Sierrastdio/Dual328P/(list of files, drawings)

Other design files:
DST.sim1
