Sierrastdio/Dual328P/(commit log)

2026-01-21 구체적인 펌웨어 재설계, 시스템 수정 반영.
2026-01-21 나노가 하나 더 추가되면서 핀배치 다시 검사해야할듯.
2026-01-21 SMU_light 버전 업로드.
2026-01-22 SMU_light 버전 수정 업로드.
2026-01-22 README 수정.
2026-01-22 IC칩 불량여부 체크중.
2026-01-22 프롬프트 파일 이동 및 README 수정.
2026-01-23 74HC04를 제외한 대략적인 회로도 첫번째 버전.
2026-01-26 74HC165 두개를 추가함으로써 Nano#2 설계 구체와, prompt.md는 아직 정보 업데이트가 안되어있고 정보충돌도 많아 잠시 사용 X.
2026-01-27 prompt.md 1차 업데이트 시도.
2026-01-29 core1firm.ino, core2firm.ino 폴더명 다른거 수정, core2firm도 코어1의 것과 같은것으로 일단 간주.
2026-01-30 코어 관련 폴더명, 파일명 수정.
2026-01-30 DDU 코드 74HC165 두개 적용된 설계 적용. 128x64 GLCD로 출력장치 변경.
2026-01-30 DDU코드 시리얼프린트 부분 전부 삭제 및 코드 수정.
2026-01-31 파이썬 인터페이스 작성. 따라서 전용 SMU_light_2.ino 생성및 작성.(+ 페이징 기능 추가)
2026-01-31 SMU_light_2 메모리 부족등 문제 해결, main.py 코드 시리얼연결 성공. SMU_light_2 넣은 아두이노에 :w 0 0 등 시도. 성공으로 추정.(RX, TX 불 들어옴)
2026-02-01 아직 작동테스트를 안한 명령어 통합 버전인 mer. light2-main 버전과 공존 시킴. 이외의 smu 예전 버전은 삭제함.
2026-02-01 추가명령어 구현시도로 인한 SMU_mer.ino 코드 수정. 이에 맞춰 대대적인 SMU업데이트와 VMF, main_mer.py 업데이트 예정.
    [SMU_mer.ino]
2026-02-01 메뉴얼부터 개판나고 핀 배치도 오류가 많은거 같아서 코드 개발은 일단 뒤로 미루고 회로도랑 핀 배치표 먼저 제대로 만들 예정.
2026-02-01 메뉴얼 수정중.
2026-02-01 코어2 주소 버퍼까지 수정함.
2026-02-02 28C256 까지 수정함.
2026-02-02 easy eda에서 회로도 28c245, 74hc04, 74hc138 배선을 주로 수정했음, 나노#1과 나노#2 회로 수정할 예정. 기념으로 A4 4장크기 회로도 프린트함.
2026-02-03 코어 배선표 수정 및 74HC04 배선표 까지 수정함.
2026-02-03 595 까지 배선표 수정함.
2026-02-03 PinManual.md 한바퀴 수정완료.
2026-02-03 코어1, 2, 28C256, 74HC245 추가 수정.
2026-02-03 28C256, 코어1, 2 추가수정.
2026-02-03 28C256 추가수정.
2026-02-03 세부 오류들 수정.
2026-02-03 74HC138 삭제, PC4로 A14 직접 제어.
2026-02-03 오류 수정.
2026-02-04 바뀐 핀맵에 맞춰 core1VMF2.ino와 SMU_mer2.ino 작성.
2026-02-04 코어용 74HC595를 두개 추가함으로서 코어당 128바이트 페이지 128개 = 총 16KB 접근 가능해짐.
2026-02-04 변경된 설계 적용 -> SMU_mer.ino, core1VMF.ino
2026-02-04 PinManual.md가 prompt.md보다 더 프롬프트 같아서 그냥 prompt.md 삭제.
2026-02-05 2월 5일 버전 회로도 업로드.
2026-02-05 근데 이거 페이지 별로 일일이 업로드 다 해야 하냐
2026-02-06 74HC595 추가한 core2 코드도 작성함.
2026-02-09 시뮬레이션 용 회로
    [DST.sim1]
2026-02-10 시뮬레이션 용 회로 만드는중.
    [DST.sim1]
2026-02-10 출력용 나노와 74HC165-1,2 의 연결만을 남겨놓음.
    [DST.sim1]
2026-02-10 명령어셋 표시
    [DST.sim1]
2026-02-11 시뮬레이션 결과, 버스 회로도 연결 이렇게 하는거 아닌거 같음, 리셋핀 제어 동작 안함, 데이터 버스로 뭔가 출력은 됐으나 주소선(74HC595-1) 부분이 반응이 없는거 같음.
    [DST.sim1]
2026-02-12 리셋핀 문제는 그냥 툴 오류였고 이제 버스 연결 안되는거 해결해야함.
    [DST.sim1]
2026-02-12 리포지토리 살짝 정리.
2026-02-14 변수명 'SP' AVR 라이브러리 충돌로 인한 컴파일 에러 해결, 포트제어 16진수에서 2진수로 바꿔 가독성 높임.
2026-02-14 TESdevac의 클로드 말로는 나노#1에 28C256의 A14가 연결되어 있지 않아 뱅크를 선택해서 데이터를 쓸수 없다고 해서 나노#1의 A5핀 사용을 PinManual.md 에 추가하고 SMU코드도 다시 짬.
2026-02-15 remove 'main.py' and rename the 'main_mer.py' to 'main.py'
    main_mer.py는 SMU와 Core가 따로 개발되었을당시 약간에 차이가 있던 명령어셋을 통합하고자 생긴 파일입니다.
    _mer가 붙은 파일들을 기반으로 개발이 진행되면서 구버전인 main.py의 이름을 main_mer.py가 계승해야 한다고 보았고, main.py는 삭제하기로 결정하였습니다.
2026-02-17 core1VMF, core2VMF의 코드 수정:
    - 공통:
    - 코드 최적화: cached_page = page >> 1 부분 쓰레기값 저장 방지를 위해 삭제.
    fetch()에서 set_page_595 호출 문제. SETPAGE에서만 호출해야 함.
    - 페이지 접근 방식 변경:
    - 페이지 전용 레지스터 추가. 슬롯의 맨 마지막 16번째 공간 사용.
    - 슬롯 공간 하나를 희생하여 4비트 명령어 + 4비트 데이터 형태로만 동작하던 SETPAGE <value> 에서
    슬롯을 통해 8비트 데이터로 코어에 저장된 상태에서 4비트 명령어를 통해 페이지 이동 범위를 늘려
    128개 페이지에 접근 못하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
2026-02-17 opcode 변수와 operand 변수에 대한 설명(주석) 추가.
2026-02-18 core1의 자체 대기 방식에서 핸드셰이크 방식으로 버스 주도권 변경방식 변경.
    core1VMF의 PC5를 이용한 DIR 제어 폐기, core2VMF의 PC5를 이용해 core2가 작업 완료후 버스 주도권 회수 허가 신호를 core1에 보내도록 변경.
2026-02-20 slots[16]에서 slots[15]로 변경하여 17개에서 16개로 줄임. 이는 4비트 명령어와 4비트 데이터 읽기 방식으로 인해 slots[16] 이상의 슬롯에 접근하는게 기본적으로 불가능하기 때문.
2026-02-21 코어간 PC5 연결 PinManual.md에 적용. 코어간 PC5 연결을 통해 코어2의 작업완료 신호를 코어1이 수신하고 코어1이 버스 주도권을 다시 가져오는 방식임을 확실히 하게 위해서 PinManual.md에 내용을 추가함.
2026-02-21 28C256 EEPROM 대신 62256 SRAM을 사용하기로 결정하면서 배치가 변경됨. 핀은 100% 호환되기 때문에 코드 변경은 불필요할것으로 예상됨.
2026-02-22 아이패드 환경 iSH 에서 푸시 테스트.
2026-02-23 ipad iSH test2
    src/VMF/core1VMF/core1VMF.ino 에서 avr 라이브러리의 레지스터, 연산자에 관한 설명 추가.
2026-02-23 :r 명령어 -> :rst 로 변경
    :run 과 :r의 구분이 명확하지 않아 코어 리셋 명령어였던 :r 명령어를 :rst로 바꿈.
2026-02-24 PINx 기능에 대한 설명 추가.
2026-02-25 slots[15] 에서 slot[15]로 변경. 뒤에 s 붙이지 않은게 더 명확하고 유지보수에 좋을것 같아서 slots[15] 에서 slot[15]로 변경함.
2026-02-26 slot[15]이 페이지 레지스터로 지정되면서 기존 예제 삭제 및 새 예제 추가
2026-02-26 slot[15]이 페이지 레지스터로 지정되면서 기존 예제 삭제 및 새 예제 추가 이전커밋에서 기존 예제 삭제 못해서 지금함.
2026-02-27 파이썬 인터페이스 코드를 좀 손봄.
2026-02-27 main.py 경량화버전 추가.
2026-02-27 mainlight.py 는 curses TUI 사용.
2026-02-27 화면 표시 오류 해결 및 포트 연결 관련 명령어들 추가.
2026-02-27 mainlight.py 와 SMU.ino 코드 호환 검증 완료. 실제 SMU의 핀의 출력 감지는 하지 않았지만 일단 시리얼 명령 수신여부는 확인됨.
2026-02-28 페이지 제어 진화적으로 에디터, SMU 개선. mainlight.py -> mainMPE.py SMUmpe.ino 추가.
    시리얼 연결, 핀 출력 확인.
2026-02-28 SMUmpe.ino 추가.
2026-03-05 실제 제작때 사용할수도 있는것들 추가 새 파일: examples/STAGE2_LED_Test.ino 새 파일: examples/STAGE4_ShiftRegister_Test.ino 새 파일: examples/STAGE5_EEPROM_Test.ino 새 파일: 검증_및_디버깅_가이드.md 새 파일: 회로_제작_로드맵.md
2026-03-07 리드미 파일 조금 작성. 수정함: README.md
2026-03-09 실제로 제작하기 시작함.
2026-03-09 내 생각에는 이거 안되는 이유가 595 두번째께 망가진게 분명함.
2026-03-13 ESC 딜레이 25ms 개선. modified: mainMPE.py
2026-03-14 보고서 작성 시작 : new file: RPT.tex
2026-03-15 보고서 수정중 modified: RPT.tex
2026-03-15 단어 오류 '코어' 수정.
2026-03-16 단어 오류 수정 'core' -> 'proc' 이름 바꿈: src/VMF/core1VMF/core1VMF.ino -> src/VMF/proc1VMF/proc1VMF.ino 이름 바꿈: src/VMF/core2VMF/core2VMF.ino -> src/VMF/proc2VMF/proc2VMF.ino
    [proc1VMF.ino, proc2VMF.ino]
2026-03-16 프로세서 인터럽트 와 버스트 모드 추가 modified: src/Nano/SMU/SMUmpe.ino modified: src/VMF/proc1VMF/proc1VMF.ino modified: src/VMF/proc2VMF/proc2VMF.ino
    검증안해봄, 이전대로 하면 듀얼이 싱글보다 비효율적일것이라는 클로드의
    예상 때문에 이렇게 만듦.
2026-03-16 연구 의의, 시사점을 찾는중 modified: RPT.tex
2026-03-21 아두이노 메가 SMU 버전 업로드. new file: src/Nano/SMU/SMUmega.ino
2026-03-26 SMUmega.ino 오류 수정
2026-03-26 새 디렉토리 추가
2026-03-26 코드 생성기 개발중
2026-03-26 .gitkeep 삭제
2026-03-31 폴더 구조 변경. 새 파일: examples/bech1.py 새 파일: examples/bench2.py 이름 바꿈: src/Nano/DDU/DDU.ino -> src/DDU/DDU.ino 이름 바꿈: src/Nano/SMU/SMU.ino -> src/SMU/SMU.ino 이름 바꿈: src/Nano/SMU/SMUmega.ino -> src/SMU/SMU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
2026-04-01 퓨즈 비트 프로그래밍을 통해 System Clock Output 기능 구현으로 Arduino Clock Generator 만듦. modified: PinManual.md
    16MHz 액티브 크리스탈 상태가 안좋아서 그냥 이렇게 쓰기로 함.
2026-04-02 나노를 ACG로 만들고 저항 3개를 병렬 연결해서 Pk-Pk 5V로 맞춤. 망가진 파형을 74HC125가 잘 해결해 줬으면 좋겠다. modified: guide.txt
2026-04-06 클럭을 16MHz 액티브 크리스탈에서 16MHz 출력 아두이노 나노 로 변경. deleted: DST.sim1 deleted: RPT.tex modified: guide.txt modified: src/SMU/SMUmega.ino
    나노를 클럭 출력모드로 설정하고 74HC125까지 동원해 오실로스코프로 파형을 관찰하였으나
    아무리봐도 진동수는 정상인데 파형이랑 Pk-Pk가 영 아니라 결국 DIP패키지 아닌 ATmega328pb칩 달린 아두이노를
    클럭 읽기 모드로 설정하고 XTAL1핀 위치를 찾아서 직접 갖다대어서 갖다대지 않을때와의 코드 업로드 성공 여부를
    비교했는데 바로 성공. 안갖다 댄건 응답 없음으로 끝나고 갖다댄건 바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
    [DST.sim1]
2026-04-06 파일명 이름 변경 및 저장소 정리. modified: guide.txt deleted: src/SMU/SMU.ino deleted: userInterface/main.py renamed: src/SMU/SMUmpe.ino -> src/SMU/SMUnano.ino renamed: userInterface/mainMPE.py -> userInterface/m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
2026-04-06 안쓸거 같은거 삭제와 파일 정리 deleted: ICtest/74HC595.ino deleted: ICtest/SN74LS245N.ino renamed: examples/bech1.py -> codeGenerator/bech1.py renamed: examples/bench2.py -> codeGenerator/bench2.py deleted: examp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
2026-04-06 4-1 사진 업로드
2026-04-06 4-6 사진 업로드
2026-04-07 예제 수정 이름변경&내용 수정: examples/test.asm -> examples/test1.asm 새 파일: examples/test2.asm
2026-04-07 리드미 파일 수정. renamed: guide.txt -> FuseBit_guide.txt modified: README.md
2026-04-07 이제 마크다운 파일에 노란 경고 하이라이트 안뜬다! modified: .vscode/settings.json
2026-04-07 이제 진짜 노란색 하이라이트 안보일거임. modified: .vscode/settings.json modified: PinManual.md modified: README.md
2026-04-08 기존 ArduinoISP 코드에서 D9핀으로 8MHz 클럭 나오게 한 코드 추가. modified: FuseBit_guide.txt modified: README.md deleted: codeGenerator/autoProgrammer.py new file: modifiedISP/modifiedISP.ino
    퓨즈 비트 만지다가 타겟 아두이노를 실수로 코드 업로드 전 클럭 입력모드로 바꿔버렸을때
    복구 용이 하도록 함. 퓨즈비트 초기화 하는 명령어를 추가했고
    ISP 프로그래머 아두이노의 D9에서 8MHz 클럭이 나와 이를 타겟 아두이노의 XTAL1에 연결한 상태에서 퓨즈비트 다시 사용해서 복구 하기 편하게 함.
2026-04-08 라이센스 명시 modified: README.md
2026-04-10 define 안쓰던거 수정. 수정함: src/SMU/SMUmega.ino
2026-04-10 주석 수정. 수정함: PinManual.md 수정함: src/VMF/proc1VMF/proc1VMF.ino 수정함: src/VMF/proc2VMF/proc2VMF.ino
    [proc1VMF.ino, proc2VMF.ino]
2026-04-10 SMU를 대체할 BPU(Binary Programmer Unit) 과 Interpreter.py 새 파일: src/BPU/BPUmega/BPUmega.ino 새 파일: src/BPU/Interpreter/Interpreter.py 이름 바꿈: src/SMU/SMUmega.ino -> src/SMU/SMUmega/SMUmega.ino 이름 바꿈: src/S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
    BASIC -> 기존 어셈블리어 -> 바이너리
    로 구조 변경함.
    약간 사용하기 더 편해짐. 파일명&구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
2026-04-10 BASIC 문법 예제 추가. 새 파일: examples/test1.bas 새 파일: examples/test2.bas 수정함: src/BPU/Interpreter/Interpreter.py
    [Interpreter.py]
2026-04-11 BPUnano 추가. deleted: FuseBit_guide.txt deleted: Images/Schematics/Sch_DST_2026-01-23.pdf deleted: Images/Schematics/Sch_DST_2026-2-5.pdf renamed: src/BPU/Interpreter/Interpreter.py -> Interpreter.py 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
2026-04-11 DDU 개선. renamed: Interpreter.py -> src/BPU/Interpreter.py modified: src/DDU/DDU.ino
2026-04-13 BPU 시스템이 바이너리 32KB용량의 파일을 제대로 수신,프로그래밍 할수 있게 변경. modified: src/BPU/BPUmega/BPUmega.ino modified: src/BPU/Interpreter.py renamed: src/DDU/DDU.ino -> src/DDU/DDU128x64/DDU128x64.ino new file: src/DDU/D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
2026-04-14 명칭변경.
2026-04-14 주석추가. modified: src/BPU/compiler.py modified: src/SMU/SMUeditor.py
2026-04-16 컴파일러 ASM, BASIC 성공 및 BPUnano에 ACK 방식 적용. modified: examples/test1.bas modified: src/BPU/BPUnano/BPUnano.ino deleted: src/BPU/Interpreter.py -> src/BPU/compiler.py modified: src/BPU/compiler.py modifi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
2026-04-16 -b 옵션 추가: 바이너리 출력 여부 선택 가능. modified: src/BPU/compiler.py
2026-04-17 compiler.py 최적화. modified: src/BPU/compiler.py
2026-04-17 타이머 추가. 근데 출력 방법좀 손좀 봐야됨. modified: src/VMF/proc1VMF/proc1VMF.ino modified: src/VMF/proc2VMF/proc2VMF.ino
2026-04-18 버그 수정. modified: src/BPU/BPUmega/BPUmega.ino modified: src/VMF/proc1VMF/proc1VMF.ino modified: src/VMF/proc2VMF/proc2VMF.ino
    [proc1VMF.ino, proc2VMF.ino]
2026-04-18 modified: src/BPU/compiler.py modified: src/VMF/proc1VMF/proc1VMF.ino modified: src/VMF/proc2VMF/proc2VMF.ino ------------설계변경------------------------------------------------ 측정 완료 → EEPROM 저장 → 전원 O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
2026-04-18 드디어 타이밍 데이터를 제대로 수집할수 있는 방법을 알아냈다. modified: src/BPU/compiler.py modified: src/BPU/BPUmega.ino modified: src/VMF/proc1VMF/proc1VMF.ino modified: src/VMF/proc2VMF/proc2VMF.ino ------------설계변경--------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
2026-04-18 퓨즈비트 설정은 선택이 아닌 필수.
2026-04-18 친절한 설명. modified: README.md
2026-04-19 32KB 풀용량 컴파일 성공. deleted: Images/2026-4-1.HEIC deleted: Images/2026-4-6.HEIC modified: README.md deleted: codeGenerator/bech1.py deleted: codeGenerator/bench2.py new file: examples/bench16K.asm new f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
2026-04-19 파일구조 변경으로 인한 리드미 반영. modified: README.md
2026-04-20 단일 프로세서 코드 추가. 본격적인 단일VS듀얼 비교를 위한 벤치마크 코드 추가. new file: examples/singleVSdual/dual_0.asm new file: examples/singleVSdual/dual_1.asm new file: examples/singleVSdual/single.asm new file: examples/singl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
2026-04-20 single.asm이 32KB아니였던거 고침. modified: examples/singleVSdual/single.asm modified: examples/singleVSdual/write_single_vs_dual_bench.py
2026-04-24 코드 주석 수정 및 README.md 수정. 수정함: README.md 수정함: src/VMF/proc1VMF/proc1VMF.ino 수정함: src/VMF/procVMF_single/procVMF_single.ino
    [proc1VMF.ino, procVMF_single.ino]
2026-04-24 /exaples 폴더 구조 정리. 수정함: README.md 이름 바꿈: examples/singleVSdual/dual_0.asm -> examples/bench/dual_0.asm 이름 바꿈: examples/singleVSdual/dual_1.asm -> examples/bench/dual_1.asm 이름 바꿈: examples/singleVSdua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
2026-04-25 쿠분투에서 zed에디터 테스트. 수정함: examples/simple_examples/test1.bas
2026-04-26 #include <Arduino.h> 수정함: src/BPU/BPUmega/BPUmega.ino 수정함: src/VMF/proc1VMF/proc1VMF.ino 수정함: src/VMF/proc2VMF/proc2VMF.ino
    [proc1VMF.ino, proc2VMF.ino]
2026-04-27 왜 proc1,2 시리얼 통신 준비가 저렇지? 새 파일: .gitignore 수정함: src/VMF/proc1VMF/proc1VMF.ino 수정함: src/VMF/proc2VMF/proc2VMF.ino
    [proc1VMF.ino, proc2VMF.ino]
2026-04-29 BPU의 등장에 맞춰 PinManual.md 수정. 이제 SMU 기준(아두이노 나노)이 아닌 BPU(아두이노 메가) 기준. 수정함: PinManual.md
2026-04-29 제목이 이상태로 얼마나 오랬동안 방치되어 있었던 거지. 수정함: PinManual.md
2026-04-30 avrdude 버전 업그레이드로 인해 파일 경로 변경. modified: README.md
2026-05-01 하드웨어 완성하고 테스트 중. modified: README.md modified: examples/upload_test/upload_test32KB.asm
    우선 당연히 실패했고 원인불명으로 Proc1의 74HC595를 과열로 날려버림.
    일단 살아있는걸로 추정되는 얘 끼움. 애매한 이유는 74HC595 남은 두개중에서 한개는 이미 죽은건데
    죽은 애를 들고왔을지도 모름(칩테스트 안함).
    진행한 테스트의 단계:
    1. BPU 전원 ON
    2. 시스템 전원 ON
    3. SRAM에 코드(examples/upload_test/upload_test32KB.asm 을 사용함.) 업로드(이 이전에 시리얼 모니터는 꺼져 있는지, 코어 RESET핀 상태가 LOW 인지 확인하기)
    4. 시리얼모니터 키고 :r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
2026-05-02 시리얼 전송 완료 대기 코드 추가. modified: src/VMF/proc1VMF/proc1VMF.ino modified: src/VMF/proc2VMF/proc2VMF.ino
2026-05-02 리셋핀 제어가 잘 안되고 꼬이는건 일단 어떻게든 해결함. modified: README.md modified: examples/upload_test/upload_test32KB.asm modified: src/BPU/BPUmega/BPUmega.ino modified: src/BPU/compiler.py 메가가 계속 리셋되는 문제(아두이노 IDE에서 시리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
2026-05-02 74HC595의 OE(G#) 연결 수정. modified: PinManual.md modified: src/VMF/proc1VMF/proc1VMF.ino modified: src/VMF/proc2VMF/proc2VMF.ino proc1VMF, proc2VMF은 코드는 수정했지만 테스트는 진행하지 않음.
    [proc1VMF.ino, proc2VMF.ino]
2026-05-03 timing_tick(actual) 이 두번 호출되고 있었음. modified: src/VMF/proc1VMF/proc1VMF.ino modified: src/VMF/proc2VMF/proc2VMF.ino
2026-05-03 EEPROM에 타이밍 결과와 regA 최종값 저장하도록 수정. (총 10 bytes) modified: src/VMF/proc1VMF/proc1VMF.ino modified: src/VMF/proc2VMF/proc2VMF.ino
    [proc1VMF.ino, proc2VMF.ino]
2026-05-03 딜레이를 좀 줄여보자 modified: src/VMF/proc1VMF/proc1VMF.ino modified: src/VMF/proc2VMF/proc2VMF.ino modified: src/VMF/procVMF_single/procVMF_single.ino
2026-05-04 프로세서 코드 수정.(캐시 메모리 구조 적용) modified: src/VMF/proc1VMF/proc1VMF.ino modified: src/VMF/proc2VMF/proc2VMF.ino
    [proc1VMF.ino, proc2VMF.ino]
2026-05-04 프로세서 코드 수정.(캐시 메모리 구조 추가) modified: src/VMF/proc1VMF/proc1VMF.ino modified: src/VMF/proc2VMF/proc2VMF.ino
    [proc1VMF.ino, proc2VMF.ino]
2026-05-04 단일프로세서 버전 업로드. modified: src/VMF/proc1VMF/proc1VMF.ino modified: src/VMF/procVMF_single/procVMF_single.ino
2026-05-08 캐시 사이즈 최적의 지점은 어디일까 modified: src/VMF/proc1VMF/proc1VMF.ino modified: src/VMF/proc2VMF/proc2VMF.ino 1페이지?
2026-05-08 리포지토리 정리 deleted: .vscode/settings.json modified: PinManual.md modified: README.md renamed: src/BPU/BPUmega/BPUmega.ino -> src/BPU/BPU.ino deleted: src/BPU/BPUnano/BPUnano.ino deleted: src/DDU/DDU128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
2026-05-09 디버그정보를 eeprom에 저장하는 기능이 있는 proc1VMF 추가. new file: src/VMF/proc1VMF_debug/proc1VMF_debug.ino
2026-05-09 74HC595 동작개선으로 페이지 전환 오버헤드 제거. modified: src/VMF/proc1VMF/proc1VMF.ino modified: src/VMF/proc2VMF/proc2VMF.ino
2026-05-09 proc2VMF.ino 상단 주석을 깜빡하고 수정 안함. modified: src/VMF/proc2VMF/proc2VMF.ino
    [proc2VMF.ino]
2026-05-10 설계 변경에 맞게 문서부분 업데이트. modified: PinManual.md modified: README.md
2026-05-11 뭔가 이상한데. deleted: .gitignore modified: README.md new file: proc1_debug_log.txt
2026-05-11 아 잠만 proc2는 128cache 버전 업로드 안한거 같은데. modified: proc1_debug_log.txt 게다가 PC가 128 안에서만 논다는 문제랑 5120UL 이것때문에 명령어 전부 측정 불가능하다는데.
2026-05-11 debug 코드도 제때 업데이트 해놓을껄! modified: proc1_debug_log.txt modified: src/VMF/proc1VMF_debug/proc1VMF_debug.ino
2026-05-11 74HC245 남는데 595쪽에다가도 245 붙여줘야 하나 고민되네. modified: README.md
2026-05-11 이슈 #3의 사안 일부 반영 modified: src/BPU/BPU.ino modified: src/VMF/proc1VMF_debug/proc1VMF_debug.ino modified: src/VMF/proc2VMF/proc2VMF.ino
2026-05-11 이거 느낌이 아주 좋지 않아요.
    595 하나 더 날려먹게 생겼네
    modified: proc1_debug_log.txt
    new file: src/EEPROMcheck/EEPROMcheck.ino
    modified: src/VMF/proc2VMF/proc2VMF.ino
    빨리 245 도입해야..
2026-05-11 왜 나한테 이런일이 modified: proc1_debug_log.txt
2026-05-12 SETPAGE 명령어 없이 순차적으로 페이지 전환하도록 하는 기능 추가. modified: src/VMF/proc1VMF/proc1VMF.ino modified: src/VMF/proc2VMF/proc2VMF.ino
2026-05-13 procVMF 전부 수정. modified: src/VMF/proc1VMF/proc1VMF.ino modified: src/VMF/proc1VMF_debug/proc1VMF_debug.ino modified: src/VMF/proc2VMF/proc2VMF.ino
    [proc1VMF.ino, proc2VMF.ino]
2026-05-17 듀얼때는 왜 데이터가 기록이 안되는지를 찾기 위한 여정. modified: PinManual.md modified: src/VMF/procVMF_single/procVMF_single.ino 그래서 기존 코어1일때 루프문에 while 문 주석처리하고 코어2 적출해서 실험해본 결과, 16384 instr in 126452 us → 7718 ns/instr
    명령어당 7.7 µs 소모.
    그리고 싱글모드 코드(딜레이 듀얼이랑 똑같이 바꾼거 전꺼)로 테스트 해보니
    +U�*��u�5120 instr in 95912 us (18732 ns/instr) regA=0x00
    너무 오래 걸려서 뭔가 이상하니까 일단 싱글코어 코드도 딜레이 숫자 듀얼이랑 맞추기로 했음.
2026-05-17 tver0.3.3 당시 환경으로 PinManual.md 수정함. modified: PinManual.md modified: README.md
2026-05-18 어이가 털리는 버그 발견 modified: src/VMF/proc1VMF/proc1VMF.ino modified: src/VMF/procVMF_single/procVMF_single.ino 여태 본인 버스 점유 차례일때 오히려 본인 버퍼를 닫아놓고 있었다고??
2026-05-18 BPU의 위험할정도로 비정상적인 발열 문제, 그리고 74HC04 1A핀과 SRAM A14핀, BPU의 뱅크 제어핀 충돌 문제. deleted: src/VMF/proc1VMF_debug/proc1VMF_debug.ino �TIMING] 16384 instr in 179095 us (10931 ns/instr) regA=0x00
    발열을 무시하고 측정한 결과 듀얼의 경우 위와같이 나왔다.
    여태 쟀던 싱글코어 데이터들으 OE가 열려있지 않았을 확률이 매우 높지만 이상하게 데이터는 나와줘서
    매우매우 혼란스럽다. 위 데이터는 버퍼 OE 제어문제를 해결했다고 판단한 후 측정한 값이다.
2026-05-19 필요없는거 삭제.
2026-05-19 가독성 올리기 modified: src/VMF/proc1VMF/proc1VMF.ino modified: src/VMF/proc2VMF/proc2VMF.ino
2026-05-30 2026-5-30-5:17부로 메인 작업 환경에서 푸시하는 계정은 TaSierra 에서 Sierrastdio 로 재변경됨. deleted: proc1_debug_log.txt
